esean/accelerometer-controlled-RC-car-demo/README.md

accelerometer-controlled-RC-car-demo
====================================

Hardware/software project that landed a job

[Watch it in action](https://www.youtube.com/watch?v=VlcvXGJSUzo)
