esean/accelerometer-controlled-RC-car-demo/SensorDesignDocuments/RC_car.xls

Sheet: FirmwareRevisions
 |  |  |  |  |  | Max RAM |  | Max Flash |  |  |  | num accel samples | time between samples | num gyro samples |  |  |  |  |  |  |  |  | NOTE: these are now taken with trig=RD6(@24ms) @5ms/div, measure on BUSYIO w/!TOP_OF_MAIN
 |  |  |  |  |  | 1536 |  | 16384 |  |  |  | 3 | 3 | 1 |  |  |  |  |  |  |  |  | busy time (%) = [voltage]/5V
 |  |  |  |  |  |  |  |  |  |  |  |  |  |  |  |  |  |  |  |  |  |  | not xmitting RS232 |  |  |  | xmitting RS232
general info |  |  |  | clocks |  | size |  |  |  | time |  |  |  |  |  |  |  |  |  |  |  | power | no writing -> RAM |  | writing samples -> RAM |  | no writing -> RAM |  | writing samples -> RAM
firmware version | firmware description |  | compiler version | clockrate | baud rate | data | Filled | program | Filled | top of main loop time | update_brain() | accel ~CS time | inter-poll time | gyro ~CS time | (2) modules total poll time | accel poll cycle | gyro poll cycle | accel 232 xmit | gyro 232 xmit | write accel->SRAM | write gyro->SRAM | LED5 only 50% | avg | rms | avg | rms | avg | rms | avg | rms
 |  | project config |  | (Fosc/4 @ RA6) | {code} | [IDE] |  | [IDE] |  | (RD5) | (RD5 manually turned on) | (RC0/accel#6) | … | (RE0/gyro#5) | … | {between ~CS} | {between ~CS} | (1:BUSYIO 2:ACCEL ~CS) | (1:BUSYIO 2:ACCEL ~CS) | (1:BUSYIO 2:ACCEL ~CS) | (1:BUSYIO 2:ACCEL ~CS) | {across PS 0.1Ω} | (RE1) | (RE1) | (RE1) | (RE1) | (RE1) | (RE1) | (RE1) | (RE1)
 |  |  |  | (MHz) | (bps) | RAM | (%) | Flash | (%) | (us) | (us) | (us) | (us) | (us) | (us) | (ms) | (ms) | (us) | (us) | (us) | (us) | (mW) | (%) | (%) | (%) | (%) | (%) | (%) | (%) | (%)
1 | first working SPI -> modules | debug | 3.3 | 1
2 | polling both modules (accel@8ms,gyro@12ms) | debug | 3.3 | 1 |  |  |  |  |  |  |  |  |  |  |  | 8 | 12
3 | (4)samples->(1)circ.buffer@250bytes | debug | 3.3 | 1 |  | 537 | 34.9609375 | 649 | 3.961181641 | 143 |  | 832 | 80 | 832 | 3568 | 8 | 12
3 | …removed one NOP in SPI fcn | debug | 3.3 | 1 |  | 537 | 34.9609375 | 649 | 3.961181641 |  |  | 812 | 80 | 812 | 3488 | 8 | 12
3 | …SPI (tight fcn) cleanup | debug | 3.3 | 1 |  | 537 | 34.9609375 | 649 | 3.961181641 |  |  | 284 | 80 | 280 | 1372 | 8 | 12
4 | (4)samples->(4)circ.buffer@250bytes | debug | 3.3 | 1 |  | 1293 | 84.1796875 | 864 | 5.2734375 |  |  |  |  |  |  | 8 | 12 |  |  |  |  | 90
5 | added buzzer | debug | 3.3 | 1 |  |  |  |  |  |  |  |  |  |  |  | 8 | 12
6 | store gyro as 10bit@125samples max | debug | 3.3 | 1 |  |  |  |  |  | 313 |  | 280 | 80 | 304 | 1384 | 8 | 12 |  |  |  |  | 100
6 | …updated compiler | debug | 3.34 | 1 |  | 1302 | 84.765625 | 1119 | 6.829833984 | 233 |  | 278 | 78 | 304 | 1372 | 8 | 12 |  |  |  |  | 100
7 | fixed buzzer bug | debug | 3.34 | 2 |  |  |  |  |  | 115 |  | 139 | 39 | 151 | 685 | 8 | 12 |  |  |  |  | 100
8 | infrast.cleanup, BUSY I/O | debug | 3.34 | 2 |  |  |  |  |  | 81 |  | 70 | 20 | 76 | 346 | 8 | 12 |  |  |  |  | 115 | 7 | 24 | 7.6 | 26
9 | PORT&LATCH bug, EUSART | debug | 3.34 | 4 | 9600 | 1303 | 84.83072917 | 1216 | 7.421875 |  |  |  |  |  |  | 8 | 12
9 | …compare @ 1MHz | debug | 3.34 | 1 | 9600 |  |  |  |  |  |  |  |  |  |  | 8 | 12 |  |  |  |  |  | 19.6 | 44 | 24 | 46
10 | working USART | debug | 3.34 | 4 | 9600 |  |  |  |  |  |  |  |  |  |  |  |  |  |  |  |  |  |  |  |  |  | 100 | 100 | 100 | 100
11 | max USART | debug | 3.34 | 4 | 115200 | 1303 | 84.83072917 | 1284 | 7.836914062 | 922 |  | 70 | 20 | 76 | 346 | 8 | 14 |  |  |  |  | 120 |  |  |  |  | 88 | 92 | 11 | 33
11 | …turn off RS233 | debug | 3.34 | 4 | 115200 | 1303 | 84.83072917 | 1284 | 7.836914062 | 80 |  | 70 | 20 | 76 | 346 | 8 | 12 |  |  |  |  | 140 | 4.5 | 20 | 5.4 | 22
11.1 | READ_accel&gyro not being cleared if LED_mode=odd, thus 232 write on each loop pass! | debug | 3.34 | 4 | 115200 | 1303 | 84.83072917 | 1296 | 7.91015625 | 37 |  | 70 | 20 | 76 | 346 | 8 | 12 | 480 | 364 | 70 | 40 | 80 |  |  |  |  | 11.7 | 29 | 12.4 | 29.7
11.1 | … turn off 232 for testing | debug | 3.34 | 4 | TURNED OFF | 1303 | 84.83072917 | 1128 | 6.884765625 | 37 |  | 70 | 20 | 76 | 346 | 8 | 12 |  |  | 70 | 40 | 80 | 3.6 | 17.8 | 4.6 | 18.7
12 | avgBuffer-232sendBreak-usingSignedArith | debug | 3.34 | 4 | 115200 | 459 | 29.8828125 | 1678 | 10.24169922 | 32.6 |  | 70 | 20 | 76 | 346 | 8 | 11.5 |  |  |  |  | 140 |  |  | 11 | 33.4 |  |  | 16.6 | 40.4
13 | derivBuffer-motionDetect_5LED_modes | release | 3.34 | 4 | 115200 | 748 | 48.69791667 | 2362 | 14.41650391 | 38.6 |  | 70 | 20 | 76 | 346 | 8 | 12 |  |  |  |  | 140 |  |  | 15.2 | 39.5 |  |  | 33 | 57
13.1 | 13.1-gyroSelfTestFix-NIGHTdef-calibBuzzerBugfix-twosCnvtFcns
14 | 14-gyro10bitUnsignedBugFix-CalibMode | debug | 3.34 | 4 | 115200 | 798 | 51.953125 | 3392 | 20.703125 | 39 |  | 70 | 20 | 76 | 346 | 8 | 12.68 |  |  |  |  | 140 |  |  | 40 | 48 |  |  | 32 | 56
14.1 | 14.1-accelSelfTest_15Percent_TODO
14.2 | 14.2-SYS_vars-always_updated | debug | 3.34 | 4 | 115200 | 740 | 48.17708333 | 3610 | 22.03369141
15 | 15-gyroDataCalibSignedFix-accelGyroInitRetry-recalibFix | debug | 3.34 | 4 | 115200 | 736 | 47.91666667 | 3636 | 22.19238281 | 36.7 |  | 70 | 20 | 76 | 346 | 8 | 10.56 |  |  |  |  | 140 |  |  | 48 | 68 |  |  | 37 | 60
16 | 16-brainCode | debug | 3.34 | 4 | 115200
16.1 | 16.1-MTHRESH_large_forJoke_autoCalib | debug | 3.34 | 4 | 115200 | 758 | 49.34895833 | 4149 | 25.32348633 | 38 | 1396 | 70 | 20 | 76 | 346 | 8 | 10.5 |  |  |  |  | 145 |  |  | 50 | 72 |  |  | 58 | 77.6
18.2 | first prototype | release | 3.34 | 4 | 115200 | 769 | 50.06510417 | 6355 | 38.7878418 | 71 | 824 | 70 | 20 | 76 | 346 | 8 | 10.5 |  |  |  |  | 175 |  |  | 72 | 86 |  |  | 51 | 70
20 | OverflowBugFixes_realTimeMovementCfgChange | debug/func.sw | 3.34 | 4 | 115200 | 790 | 51.43229167 | 5601 | 34.18579102 | 71.6 |  | 70 | 20 | 76 | 346 | 8 | 12 |  |  |  |  | 155 |  |  | 74 | 86 |  |  | 42 | 64
20 | … | dbg_const_adc_adjust | 3.34 | 4 | 115200 | 790 | 51.43229167 | 5914 | 36.09619141 | 73 |  | 70 | 20 | 76 | 346 | 8 | 10.5 |  |  |  |  | 155 |  |  | 72 | 85.6 |  |  | 32 | 57
20.1 | 20.1-SlowedRealTimeUpdatesForBetterPerformance
21 | 21-FixedGYRO_READ_TOO_EARLY_sensorSamplingRearrangement
22 | 22-SENSORS_UPdefine_JOKIEbuzzerWorking
23 | 23-speedSteerCompensationAlgorithm | debug | 3.34 | 4 | 115200 | 818 | 53.25520833 | 6674 | 40.73486328 | 70 |  | 70 | 20 | 76 | 346 | 8 | 12 |  |  |  |  |  |  |  | 47 | 66 |  |  | 62 | 75
25 | 25-gyroAmplifiesSteering-smallerFilterBuffers | release | 3.34 | 4 | 115200 | 654 | 42.578125 | 7053 | 43.0480957 | 33.8 |  | 70 | 20 | 76 | 346 | 8 | 12 |  |  |  |  |  |  |  | 24 | 47.8 |  |  | 33 | 57

Sheet: MotionStates
 | Average & derivative
Movement | x | y | z | g
flat -> point up | - |  | -
point up -> flat | + |  | +
flat -> point down | + |  | -
point down -> flat | - |  | +
flat -> right down |  | - | -
right down -> flat |  | + | +
flat -> left down |  | + | -
left down -> flat |  | - | +
g' vector

Sheet: sensor sampling sequence
Timer0 count [4ms] | Time (ms) | accel RDY | gyro RDY | update_brain | main_rc_car()
1 | 4 | 0 | 0 | 0 | 0
2 | 8[+1ms] | 1 | 0 | 1 | 0
3 | 12 | 0 | 1 | 0 | 1
4 | 16[+1ms] | 1 | 0 | 0 | 0
5 | 20 | 0 | 0 | 0 | 0
6 | 24 | 1 | 1 | 0 | 0
(... pattern repeats...)

Sheet: SensorModules
 | Axis | Range | Output | Power | Voltage | Sampe Rate | Interface | Write offset
Accelerometer | 3 | +/- 2g | signed 8bit | 3mA | 2.5-5.5v | 125, 250Hz | SPI, I2C | Yes
Gyrometer | 1 | +/-300deg | unsigned 10bit | 5.25mA | 3.4-6.5v | 88Hz | SPI | No
