esean/accelerometer-controlled-RC-car-demo/SensorDesignDocuments/SchematicBlockDiagrams/RC_car_schematic.pdf

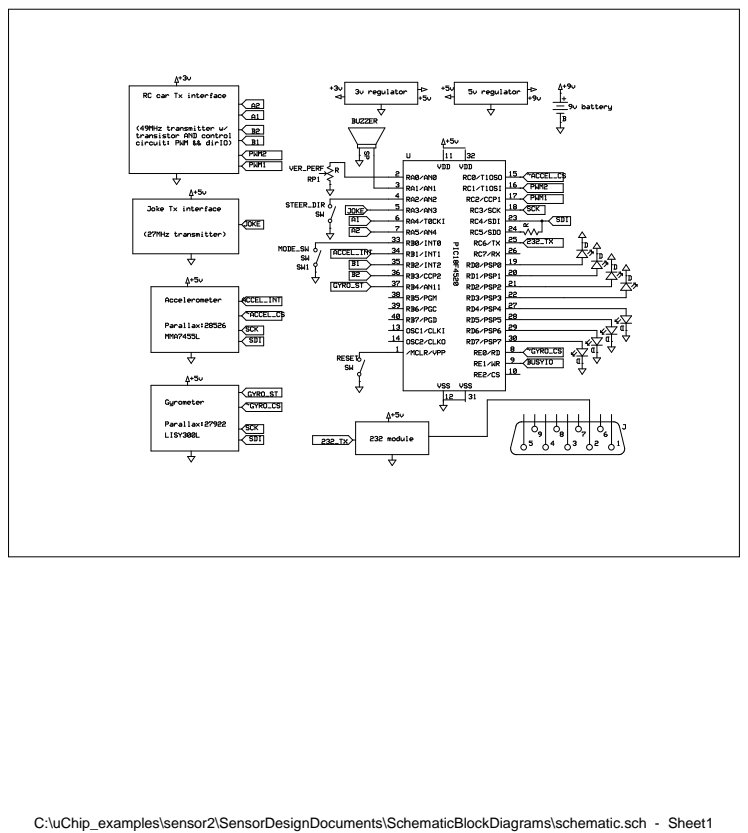
[picture p1: page 1]

C:\uChip_examples\sensor2\SensorDesignDocuments\SchematicBlockDiagrams\schematic.sch - Sheet1
