esean/accelerometer-controlled-RC-car-demo/SensorDesignDocuments/SchematicBlockDiagrams/txUnitInterface.pdf

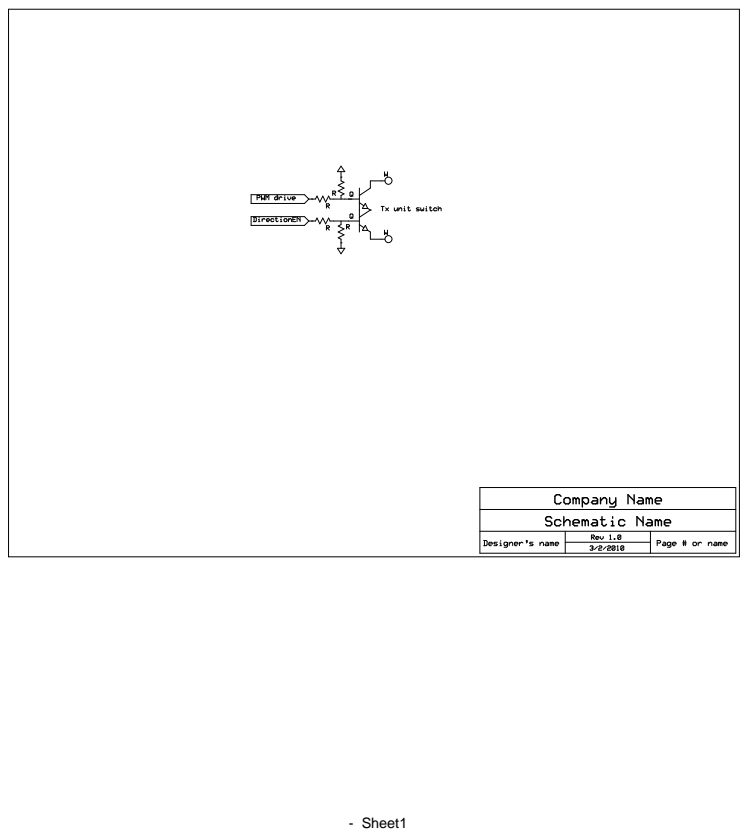
[picture p2: page 1]
- Sheet1
